JIMS-Innovations/BLDCM-ESC/README.md

This repository contains the firmware, design files and documents for a Sensorless Electronic Speed Controller (for brushless DC motors) developed by Jesutofunmi Kupoluyi.
