JIMS-Innovations/BLDCM-ESC/Hardware/BLDC ESC/BLDC ESC.kicad_pcb

## KiCad design Hardware/BLDC ESC/BLDC ESC.kicad_pcb (2024-01-21)

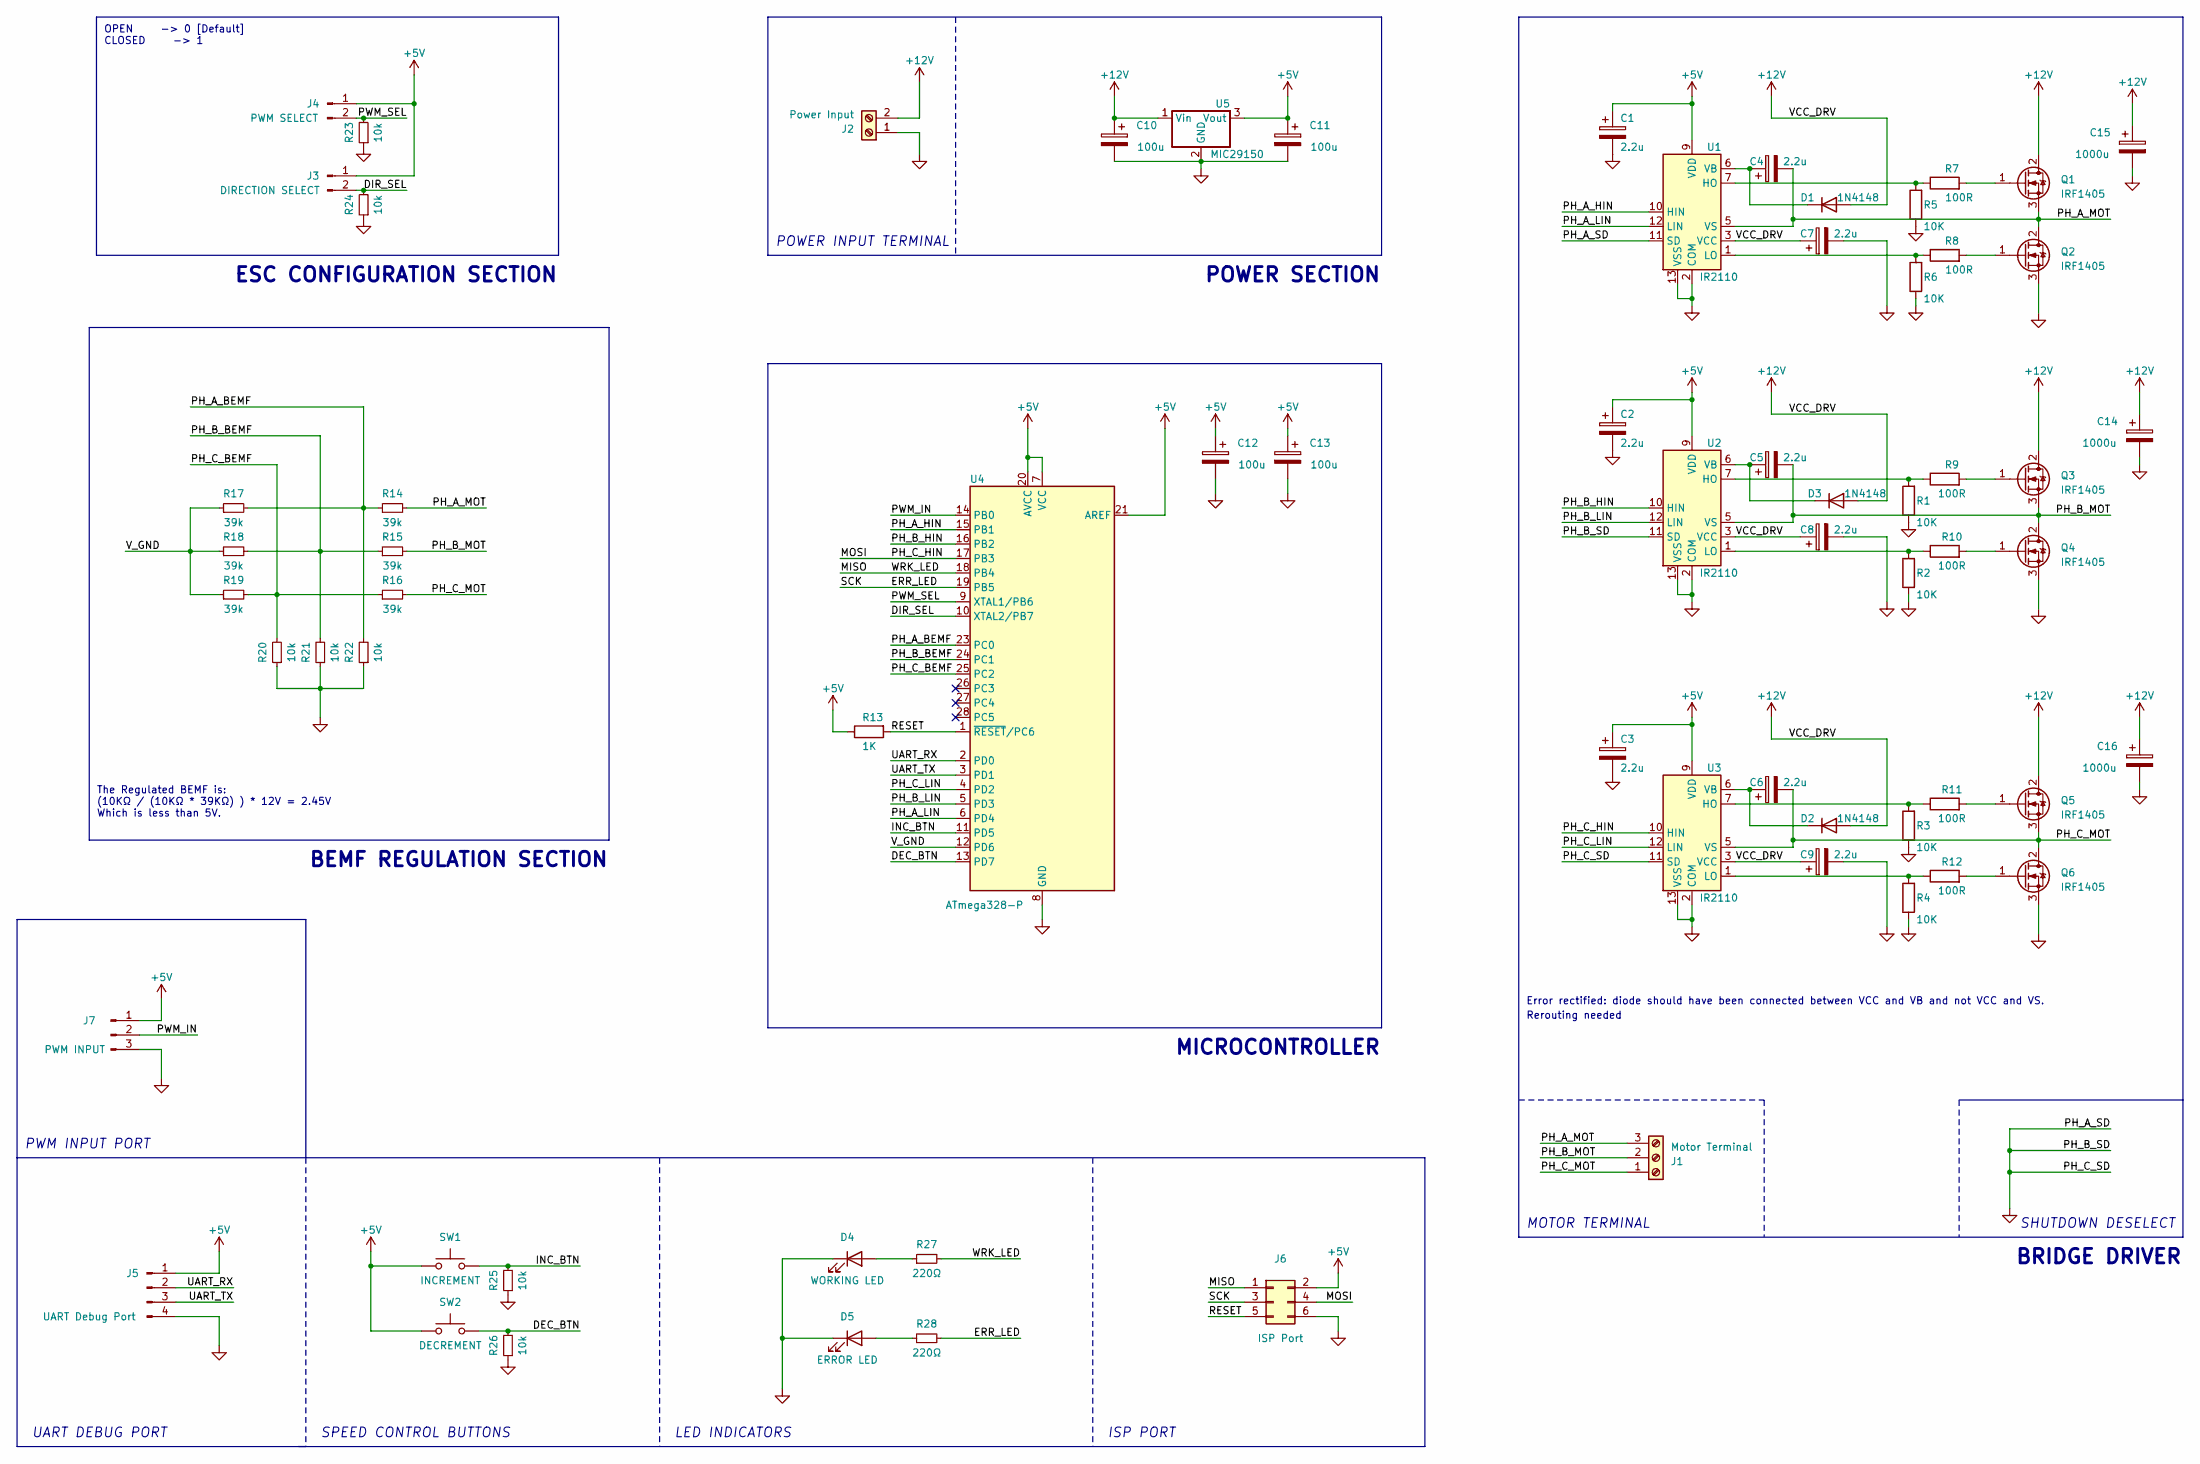
[picture p1: schematic BLDC ESC.kicad_sch]

Parts:
C1, C2, C3, C4, C5, C6, C7, C8, C9: 2.2u; CP_Radial_D5.0mm_P2.00mm
C10, C11, C12, C13: 100u; CP_Radial_D5.0mm_P2.50mm
C14, C15, C16: 1000u; CP_Radial_D14.0mm_P7.50mm
D1, D2, D3: 1N4148; D_A-405_P10.16mm_Horizontal
D4: WORKING LED; LED_D5.0mm
D5: ERROR LED; LED_D5.0mm
J1: Motor Terminal; TerminalBlock_bornier-3_P5.08mm
J2: Power Input; TerminalBlock_bornier-2_P5.08mm
J3: DIRECTION SELECT; PinHeader_1x02_P2.54mm_Vertical
J4: PWM SELECT; PinHeader_1x02_P2.54mm_Vertical
J5: UART Debug Port; PinHeader_1x04_P2.54mm_Vertical
J6: ISP Port; PinHeader_2x03_P2.54mm_Vertical
J7: PWM INPUT; PinHeader_1x03_P2.54mm_Vertical
Q1, Q2, Q3, Q4, Q5, Q6: IRF1405; TO-220-3_Vertical
R1, R2, R3, R4, R5, R6: 10K; R_Axial_DIN0207_L6.3mm_D2.5mm_P10.16mm_Horizontal
R7, R8, R9, R10, R11, R12: 100R; R_Axial_DIN0207_L6.3mm_D2.5mm_P10.16mm_Horizontal
R13: 1K; R_Axial_DIN0207_L6.3mm_D2.5mm_P10.16mm_Horizontal
R14, R15, R16, R17, R18, R19: 39k; R_Axial_DIN0207_L6.3mm_D2.5mm_P10.16mm_Horizontal
R20, R21, R22, R23, R24, R25, R26: 10k; R_Axial_DIN0207_L6.3mm_D2.5mm_P10.16mm_Horizontal
R27, R28: 220Ω; R_Axial_DIN0207_L6.3mm_D2.5mm_P10.16mm_Horizontal
SW1: INCREMENT; SW_PUSH_6mm
SW2: DECREMENT; SW_PUSH_6mm
U1, U2, U3: IR2110; DIP-14_W7.62mm
U4: ATmega328-P; DIP-28_W7.62mm
U5: MIC29150; TO-220-3_Vertical

Connections:
+5V: C1.1, C2.1, C3.1, C11.1, C12.1, C13.1, J3.1, J4.1, J5.1, J6.2, J7.1, R13.1, SW1.1, SW2.1, U1.9 (VDD), U2.9 (VDD), U3.9 (VDD), U4.7 (VCC), U4.20 (AVCC), U4.21 (AREF), U5.3 (Vout)
+12V: C7.1, C8.1, C9.1, C10.1, C14.1, C15.1, C16.1, D1.2 (A), D2.2 (A), D3.2 (A), J2.2, Q1.2 (D), Q3.2 (D), Q5.2 (D), U1.3 (VCC), U2.3 (VCC), U3.3 (VCC), U5.1 (Vin)
/DEC_BTN: R26.2, SW2.2, U4.13 (PD7)
/DIR_SEL: J3.2, R24.2, U4.10 (XTAL2/PB7)
/ERR_LED: J6.3, R28.2, U4.19 (PB5)
/INC_BTN: R25.2, SW1.2, U4.11 (PD5)
/MISO: J6.1, R27.2, U4.18 (PB4)
/MOSI: J6.4, U3.10 (HIN), U4.17 (PB3)
/PH_A_BEMF: R14.1, R17.2, R22.2, U4.23 (PC0)
/PH_A_HIN: U1.10 (HIN), U4.15 (PB1)
/PH_A_LIN: U1.12 (LIN), U4.6 (PD4)
/PH_A_MOT: C4.2, J1.3, Q1.3 (S), Q2.2 (D), R14.2, U1.5 (VS)
/PH_B_BEMF: R15.1, R18.2, R21.2, U4.24 (PC1)
/PH_B_HIN: U2.10 (HIN), U4.16 (PB2)
/PH_B_LIN: U2.12 (LIN), U4.5 (PD3)
/PH_B_MOT: C5.2, J1.2, Q3.3 (S), Q4.2 (D), R15.2, U2.5 (VS)
/PH_C_BEMF: R16.1, R19.2, R20.2, U4.25 (PC2)
/PH_C_LIN: U3.12 (LIN), U4.4 (PD2)
/PH_C_MOT: C6.2, J1.1, Q5.3 (S), Q6.2 (D), R16.2, U3.5 (VS)
/PWM_IN: J7.2, U4.14 (PB0)
/PWM_SEL: J4.2, R23.2, U4.9 (XTAL1/PB6)
/RESET: J6.5, R13.2, U4.1 (~RESET/PC6)
/UART_RX: J5.2, U4.2 (PD0)
/UART_TX: J5.3, U4.3 (PD1)
/V_GND: R17.1, R18.1, R19.1, U4.12 (PD6)
GND: C1.2, C2.2, C3.2, C7.2, C8.2, C9.2, C10.2, C11.2, C12.2, C13.2, C14.2, C15.2, C16.2, D4.1 (K), D5.1 (K), J2.1, J5.4, J6.6, J7.3, Q2.3 (S), Q4.3 (S), Q6.3 (S), R1.1, R2.1, R3.1, R4.1, R5.1, R6.1, R20.1, R21.1, R22.1, R23.1, R24.1, R25.1, R26.1, U1.2 (COM), U1.11 (SD), U1.13 (VSS), U2.2 (COM), U2.11 (SD), U2.13 (VSS), U3.2 (COM), U3.11 (SD), U3.13 (VSS), U4.8 (GND), U4.22 (GND), U5.2 (GND)
unnamed: C4.1, D1.1 (K), U1.6 (VB)
unnamed: C6.1, D2.1 (K), U3.6 (VB)
unnamed: C5.1, D3.1 (K), U2.6 (VB)
unnamed: D4.2 (A), R27.1
unnamed: D5.2 (A), R28.1
unnamed: Q1.1 (G), R7.2
unnamed: Q2.1 (G), R8.2
unnamed: Q3.1 (G), R9.2
unnamed: Q4.1 (G), R10.2
unnamed: Q5.1 (G), R11.2
unnamed: Q6.1 (G), R12.2
unnamed: R5.2, R7.1, U1.7 (HO)
unnamed: R6.2, R8.1, U1.1 (LO)
unnamed: R1.2, R9.1, U2.7 (HO)
unnamed: R2.2, R10.1, U2.1 (LO)
unnamed: R3.2, R11.1, U3.7 (HO)
unnamed: R4.2, R12.1, U3.1 (LO)

Notes on the sheet:
SHUTDOWN DESELECT
UART DEBUG PORT
PWM INPUT PORT
BEMF REGULATION SECTION
POWER SECTION
The Regulated BEMF is: (10KΩ / (10KΩ * 39KΩ) ) * 12V = 2.45V Which is less than 5V.
Error rectified: diode should have been connected between VCC and VB and not VCC and VS.
POWER INPUT TERMINAL
MICROCONTROLLER
ISP PORT
BRIDGE DRIVER
LED INDICATORS
ESC CONFIGURATION SECTION
Rerouting needed
SPEED CONTROL BUTTONS
MOTOR TERMINAL
OPEN -> 0 [Default] CLOSED -> 1

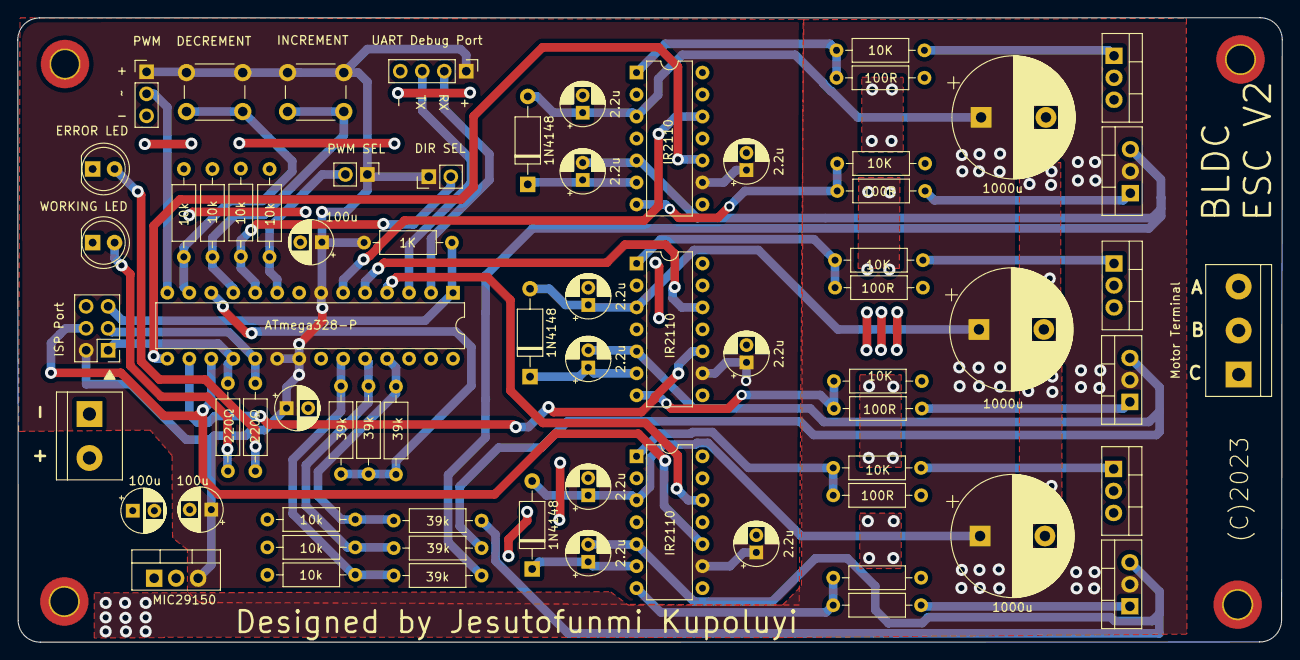
[picture p2: board BLDC ESC.kicad_pcb from above]

Board: 2 copper layers, 146.2 x 72.2 mm, 69 parts (0 on the bottom side), 43 nets.
