JIMS-Innovations/BLDCM-ESC/(commit log)

2024-01-14 Basic features completed
    [BLDC ESC - V1.kicad_pcb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]
2024-01-21 PCB errors corrected
    [BLDC ESC.kicad_pcb]
2024-01-23 Update fabrication outputs
    [BLDC ESC-B_Adhesive.gbr, BLDC ESC-B_Courtyard.gbr, BLDC ESC-B_Cu.gbr, BLDC ESC-B_Mask.gbr, BLDC ESC-B_Paste.gbr, BLDC ESC-B_Silkscreen.gbr, BLDC ESC-Edge_Cuts.gbr, BLDC ESC-F_Adhesive.gbr]
